LeMarsito02/IOTPROYECTOFINAL2CORTE/(commit log)

2026-09-29 README: referencias, imagenes del primer corte, v7 y gitignore de material con derechos
2026-09-29 README: costo del prototipo, nota de librerias y referencias
